AlishaG15/Lightbox-MedTechPrototyping/README.md

# Lightbox

A custom embedded systems project built for MedTech Prototyping (BME 254) at Duke University, Spring 2026 — a 3D-printed panda enclosure housing a hand-soldered PCB, Arduino Nano Every, and three independently controlled LEDs (two eyes and a nose).

---

## Overview

When a button is pressed, the panda's eyes light up for 5 seconds and its nose blinks for 10 seconds. The brightness of the eyes and blink rate of the nose are each controlled by a dedicated potentiometer mounted in the ears. An onboard heartbeat LED blinks at 1 Hz in all states to confirm the device is running.

---

## Hardware

| Component | Detail |
|---|---|
| Microcontroller | Arduino Nano Every (ATmega4809) |
| PCB | Custom single-sided board, hand-milled and soldered |
| LED drivers | IRFZ44 N-channel MOSFETs |
| Enclosure | 3D-printed PLA, two-part snap fit |
| Power | 9 V battery with SPST toggle switch |
| Controls | SPST push button + 2× 10 kΩ potentiometers |

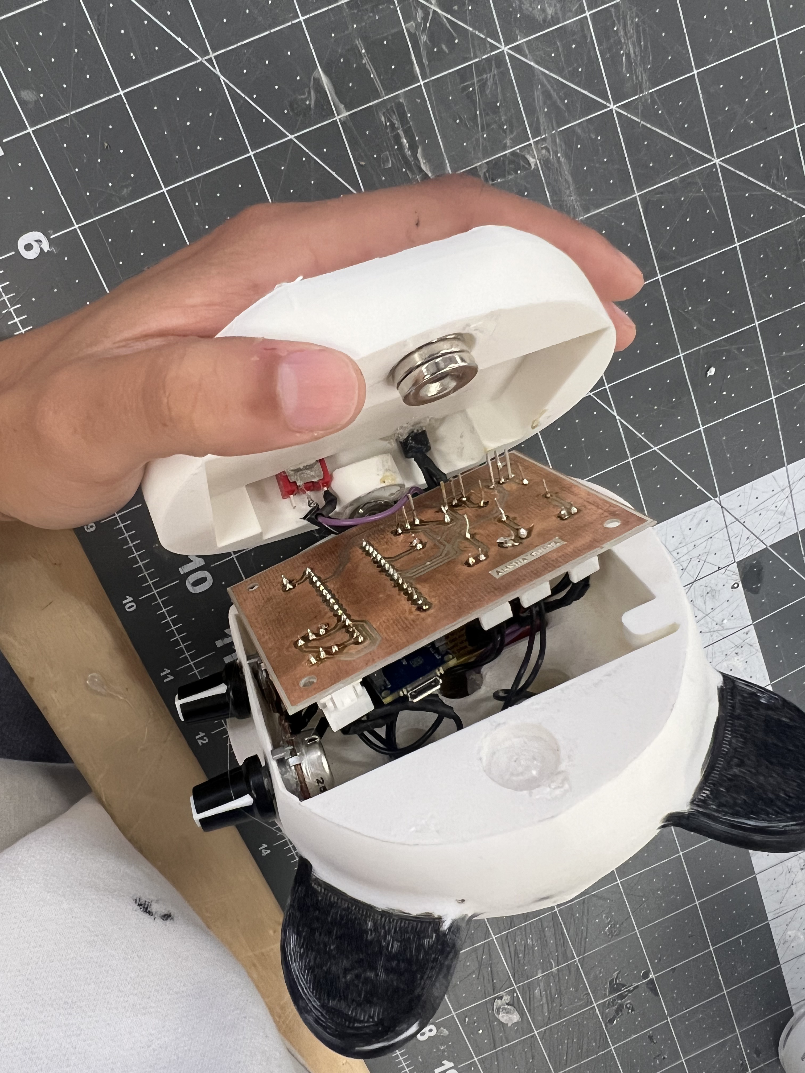
[picture p1: images/IMG_6919.jpeg]
Internals

Side view with potentiometers


---

## Firmware

Written in C++ using the Arduino framework via PlatformIO. Key design decisions:

- **State machine** with three explicit states: `IDLE`, `ANALOG_READ`, and `LED_OUTPUT`
- **Interrupt-driven** button input using `attachInterrupt()` — no polling in the main loop
- **Non-blocking timing** throughout using `millis()` — no `delay()` calls anywhere
- **PWM brightness control** on the eye LEDs via `analogWrite()`, mapped linearly from the potentiometer ADC reading
- **Clean digital blink** on the nose LED using `digitalWrite()` to avoid the Nano Every's 255/256 PWM artifact
- All pin assignments and timing constants defined as `#define` macros at the top of the file

```
IDLE ──(button press)──▶ ANALOG_READ ──▶ LED_OUTPUT ──(10 s elapsed)──▶ IDLE
```

---

## Testing Results

All measurements taken with a Tektronix TBS 1102B oscilloscope. Full analysis, with regression fits and 95% confidence intervals, is in the [technical report](testing/technical_report.ipynb) ([HTML version](testing/technical_report.html)); raw data is in [`testing/`](testing).

**Heartbeat LED**
- Period: 1000 ms, Frequency: 1.000 Hz, Duty cycle: 50.0%
- Identical in both IDLE and LED_OUTPUT states
- Zero measurable variation across 10 trials in each state (limited by oscilloscope resolution)

**Eye LED brightness (vs. potentiometer resistance)**
- Linear relationship (R² ≈ 1.0) from 0% duty cycle at max resistance to ~80% at minimum
- Did not reach 100% due to potentiometer mechanical travel limits

**Nose LED blink rate (vs. potentiometer resistance)**
- Linear relationship from 5.00 Hz (max resistance) to 7.45 Hz (min resistance)
- Lower bound matches spec exactly; upper bound limited by the same pot range constraint

---

## Gallery

| Assembled | Back panel |
|---|---|
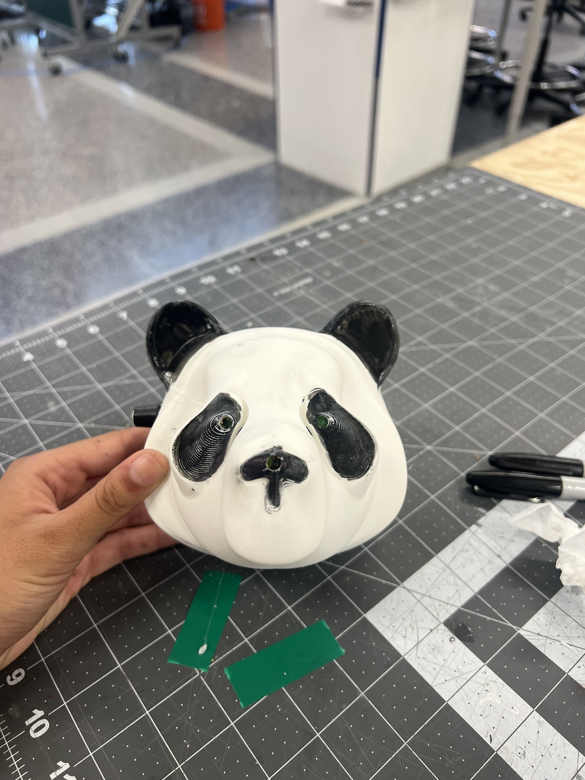
[picture p3: images/IMG_6915.jpeg]
front
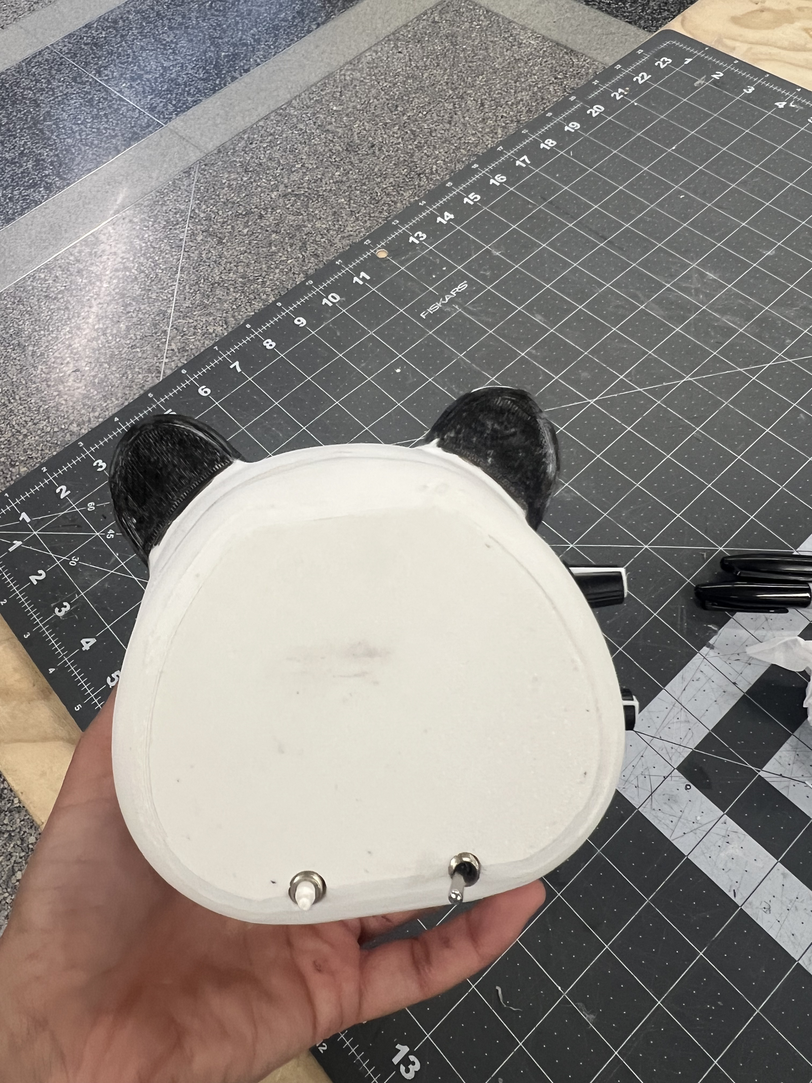
[picture p4: images/IMG_6917.jpeg]
back
|  |  |

| Internals (PCB) | Internals (Arduino + connectors) |
|---|---|
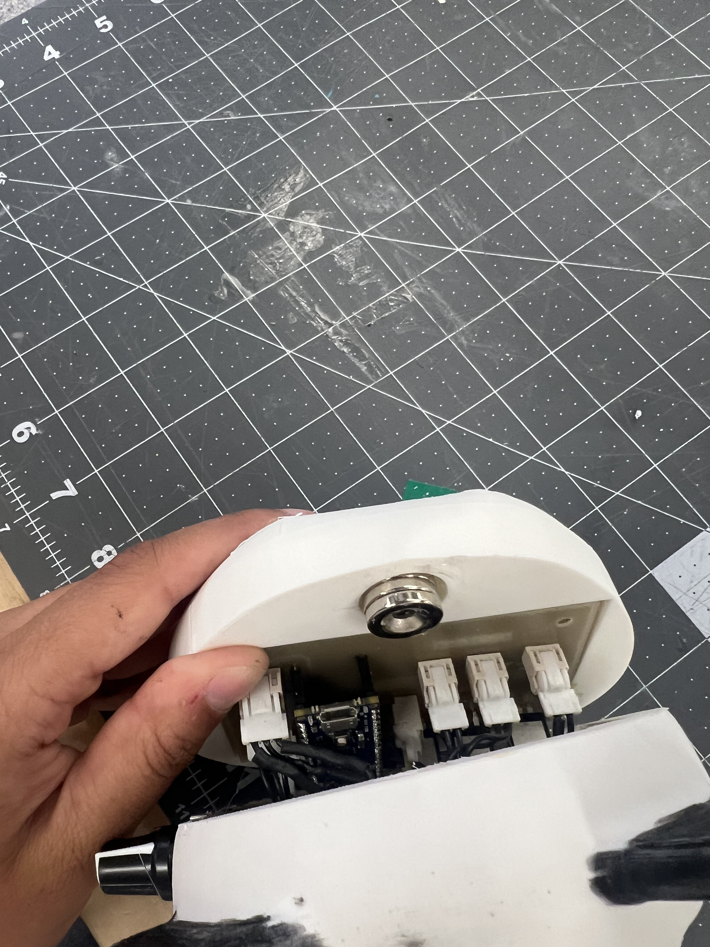
[picture p5: images/IMG_6920.jpeg]
arduino
| pcb |  |

---

## Repository Layout

| Folder | Contents |
|---|---|
| [`src/`](src) | Firmware (`main.cpp`) |
| [`circuit/`](circuit) | KiCad schematic, PCB layout and MOSFET footprint |
| [`cad/`](cad) | Enclosure renders |
| [`testing/`](testing) | Oscilloscope data and technical report |
| [`images/`](images) | Photos of the assembled device |

---

## Built With

- **PlatformIO** — build system and upload toolchain
- **KiCad** — schematic capture and PCB layout
- **Fusion 360 / CAD** — enclosure design
- **Python / Jupyter** — data analysis and technical report (scipy, matplotlib, pandas)
