AlishaG15/Lightbox-MedTechPrototyping/images/IMG_6918.jpeg

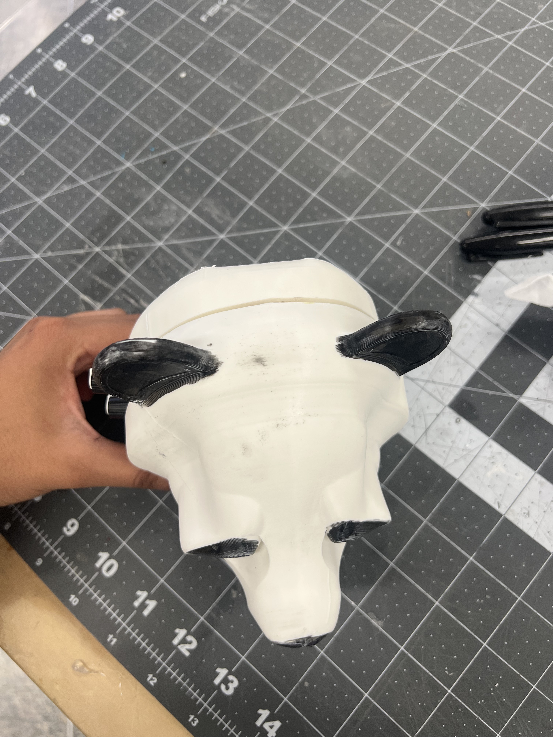
images/IMG_6918.jpeg
