AlishaG15/Lightbox-MedTechPrototyping/circuit/IRFZ44N/IRFZ44N.step

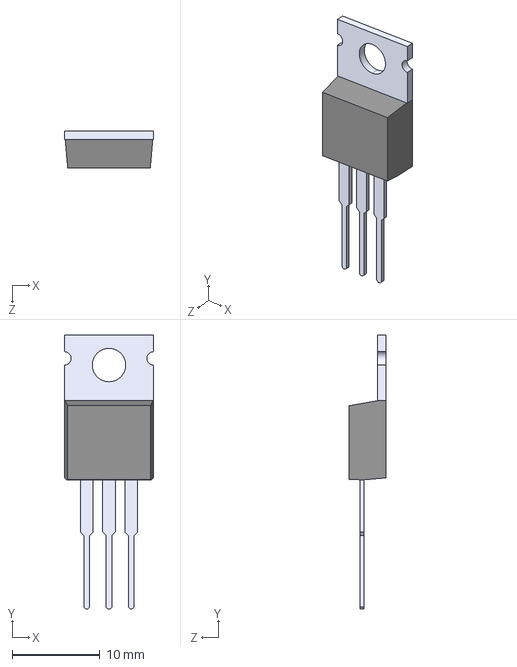
[picture p10: CAD file, 2025-03-25]
circuit/IRFZ44N/IRFZ44N.step
10.2 x 31.2 x 4.19 mm
