AlishaG15/Lightbox-MedTechPrototyping/testing/data_eye.csv

resistance_kohms | duty_cycle_pct
4.618 | 0.0
4.618 | 0.0
4.618 | 0.0
4.618 | 0.0
4.618 | 0.0
4.483 | 20.7
4.483 | 20.0
4.483 | 20.6
4.483 | 20.8
4.483 | 20.3
3.438 | 40.4
3.438 | 40.3
3.438 | 40.5
3.438 | 40.3
3.438 | 40.4
2.020 | 60.4
2.020 | 60.4
2.020 | 60.6
2.020 | 60.6
2.020 | 60.6
0.002 | 80.3
0.002 | 80.1
0.002 | 80.1
0.002 | 80.7
0.002 | 80.1
