AlishaG15/Lightbox-MedTechPrototyping/testing/data_heartbeat.csv

state | trial | period_ms | frequency_hz | duty_cycle_pct
IDLE | 1 | 1000 | 1.000 | 50.0
IDLE | 2 | 1000 | 1.000 | 50.0
IDLE | 3 | 1000 | 1.000 | 50.0
IDLE | 4 | 1000 | 1.000 | 50.0
IDLE | 5 | 1000 | 1.000 | 50.0
IDLE | 6 | 1000 | 1.000 | 50.0
IDLE | 7 | 1000 | 1.000 | 50.0
IDLE | 8 | 1000 | 1.000 | 50.0
IDLE | 9 | 1000 | 1.000 | 50.0
IDLE | 10 | 1000 | 1.000 | 50.0
LED_OUTPUT | 1 | 1000 | 1.000 | 50.0
LED_OUTPUT | 2 | 1000 | 1.000 | 50.0
LED_OUTPUT | 3 | 1000 | 1.000 | 50.0
LED_OUTPUT | 4 | 1000 | 1.000 | 50.0
LED_OUTPUT | 5 | 1000 | 1.000 | 50.0
LED_OUTPUT | 6 | 1000 | 1.000 | 50.0
LED_OUTPUT | 7 | 1000 | 1.000 | 50.0
LED_OUTPUT | 8 | 1000 | 1.000 | 50.0
LED_OUTPUT | 9 | 1000 | 1.000 | 50.0
LED_OUTPUT | 10 | 1000 | 1.000 | 50.0
