AlishaG15/Lightbox-MedTechPrototyping/testing/data.csv

Ideal Period (ms) | Measurement Period (ms)
1000 | 1005
1000 | 1003
1000 | 1001
1000 | 990
1000 | 995
500 | 490
500 | 495
500 | 497
500 | 492
500 | 491
2000 | 2100
2000 | 2000
2000 | 2300
2000 | 1900
2000 | 1950
