AlishaG15/Lightbox-MedTechPrototyping/testing/data_nose.csv

resistance_kohms | frequency_hz | period_ms
0.002 | 7.441 | 134.3
0.002 | 7.452 | 134.2
0.002 | 7.446 | 134.2
0.002 | 7.452 | 134.1
0.002 | 7.342 | 136.2
1.566 | 6.897 | 145.0
1.566 | 6.849 | 146.0
1.566 | 6.849 | 146.0
1.566 | 6.849 | 146.0
1.566 | 6.849 | 146.0
3.420 | 6.089 | 164.0
3.420 | 6.135 | 163.0
3.420 | 6.135 | 163.0
3.420 | 6.135 | 163.0
3.420 | 6.135 | 163.0
4.320 | 5.376 | 186.0
4.320 | 5.376 | 186.0
4.320 | 5.376 | 186.0
4.320 | 5.376 | 186.0
4.320 | 5.376 | 186.0
4.622 | 5.051 | 198.0
4.622 | 5.000 | 200.0
4.622 | 5.051 | 198.0
4.622 | 5.051 | 198.0
4.622 | 5.051 | 198.0
