AlishaG15/Lightbox-MedTechPrototyping/circuit/circuit.kicad_pcb

## KiCad design circuit/circuit.kicad_pcb (2026-04-01)

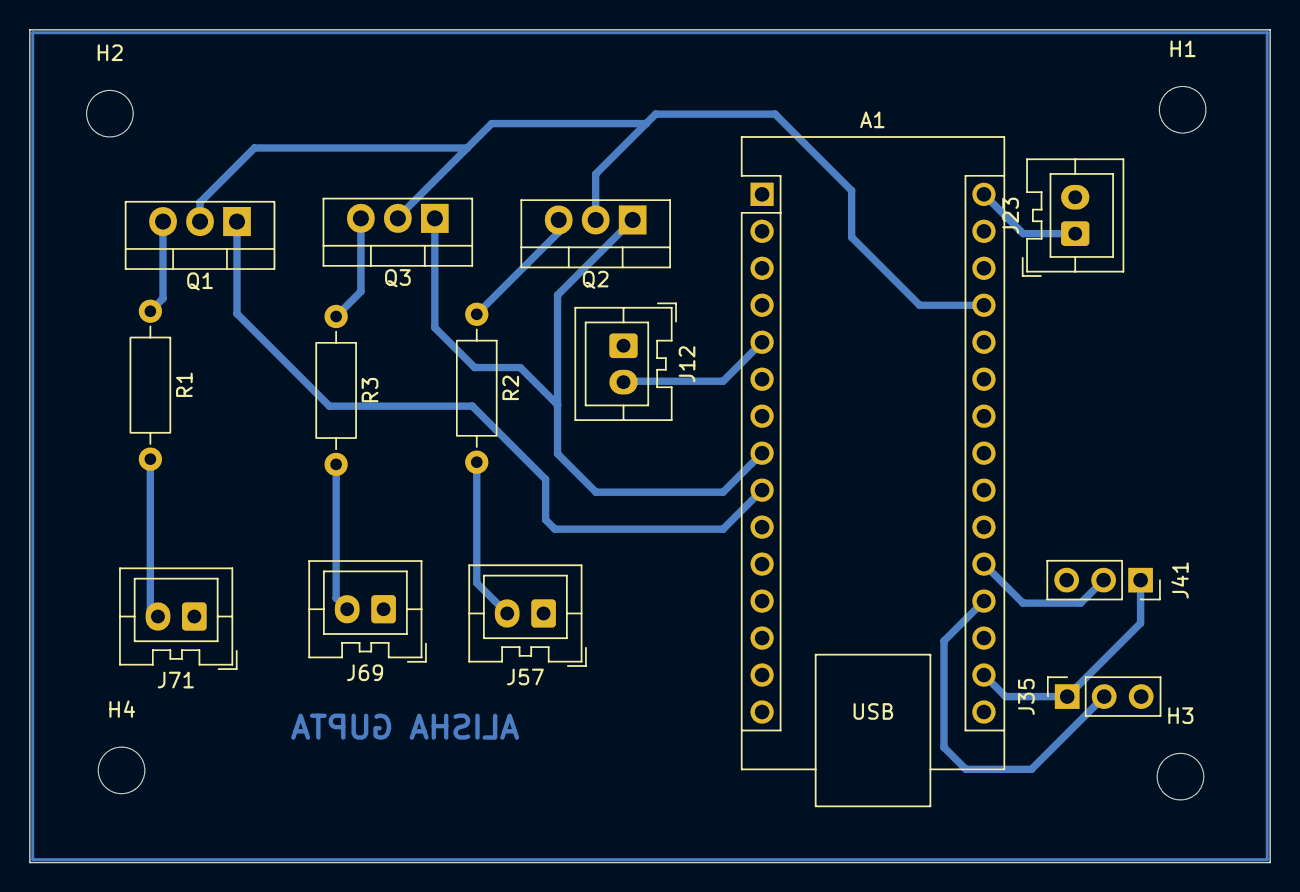
[picture p11: board circuit.kicad_pcb from above]

Board: 2 copper layers, 85.2 x 57.2 mm, 18 parts (0 on the bottom side), 15 nets.

Parts:
A1: Arduino_Nano_Every; Arduino_Nano
H1, H2, H3, H4: MountingHole; MountingHole_3.2mm_M3
J12, J23: Conn_01x02_Pin; JST_XA_B02B-XASK-1_1x02_P2.50mm_Vertical
J35: POT_BRIGHT_CONN; PinSocket_1x03_P2.54mm_Vertical
J41: POT_BLINK_CONN; PinSocket_1x03_P2.54mm_Vertical
J57, J69, J71: B02B-XASK-1; JST_XA_B02B-XASK-1_1x02_P2.50mm_Vertical
Q1, Q2, Q3: IRFZ44N; TO-220-3_Vertical
R1, R2, R3: 1k; R_Axial_DIN0207_L6.3mm_D2.5mm_P10.16mm_Horizontal

Connections:
+3.3V: A1.17 (3V3), J35.1, J41.1
+5V: A1.27 (+5V), Q1.2, Q2.2, Q3.2
+9V: A1.30 (VIN), J23.1
BLINK_OUT: A1.9 (D6), Q1.1
BRIGHT_OUT: A1.8 (D5), Q2.1, Q3.1
BUTTON_IN: A1.5 (D2), J12.2
GND: A1.4 (GND), A1.29 (GND), J12.1, J23.2, J35.3, J41.3, J57.1, J69.1, J71.1
unnamed: J57.2, R2.2
unnamed: J69.2, R3.2
unnamed: J71.2, R1.2
unnamed: Q1.3, R1.1
unnamed: Q2.3, R2.1
unnamed: Q3.3, R3.1
POT_BLINK: A1.20 (A1), J41.2
POT_BRIGHT: A1.19 (A0), J35.2
