AlishaG15/Lightbox-MedTechPrototyping/Lightbox V2/circuit copy/circuit.kicad_sch

## KiCad design Lightbox V2/circuit copy/circuit.kicad_sch (2026-03-29)

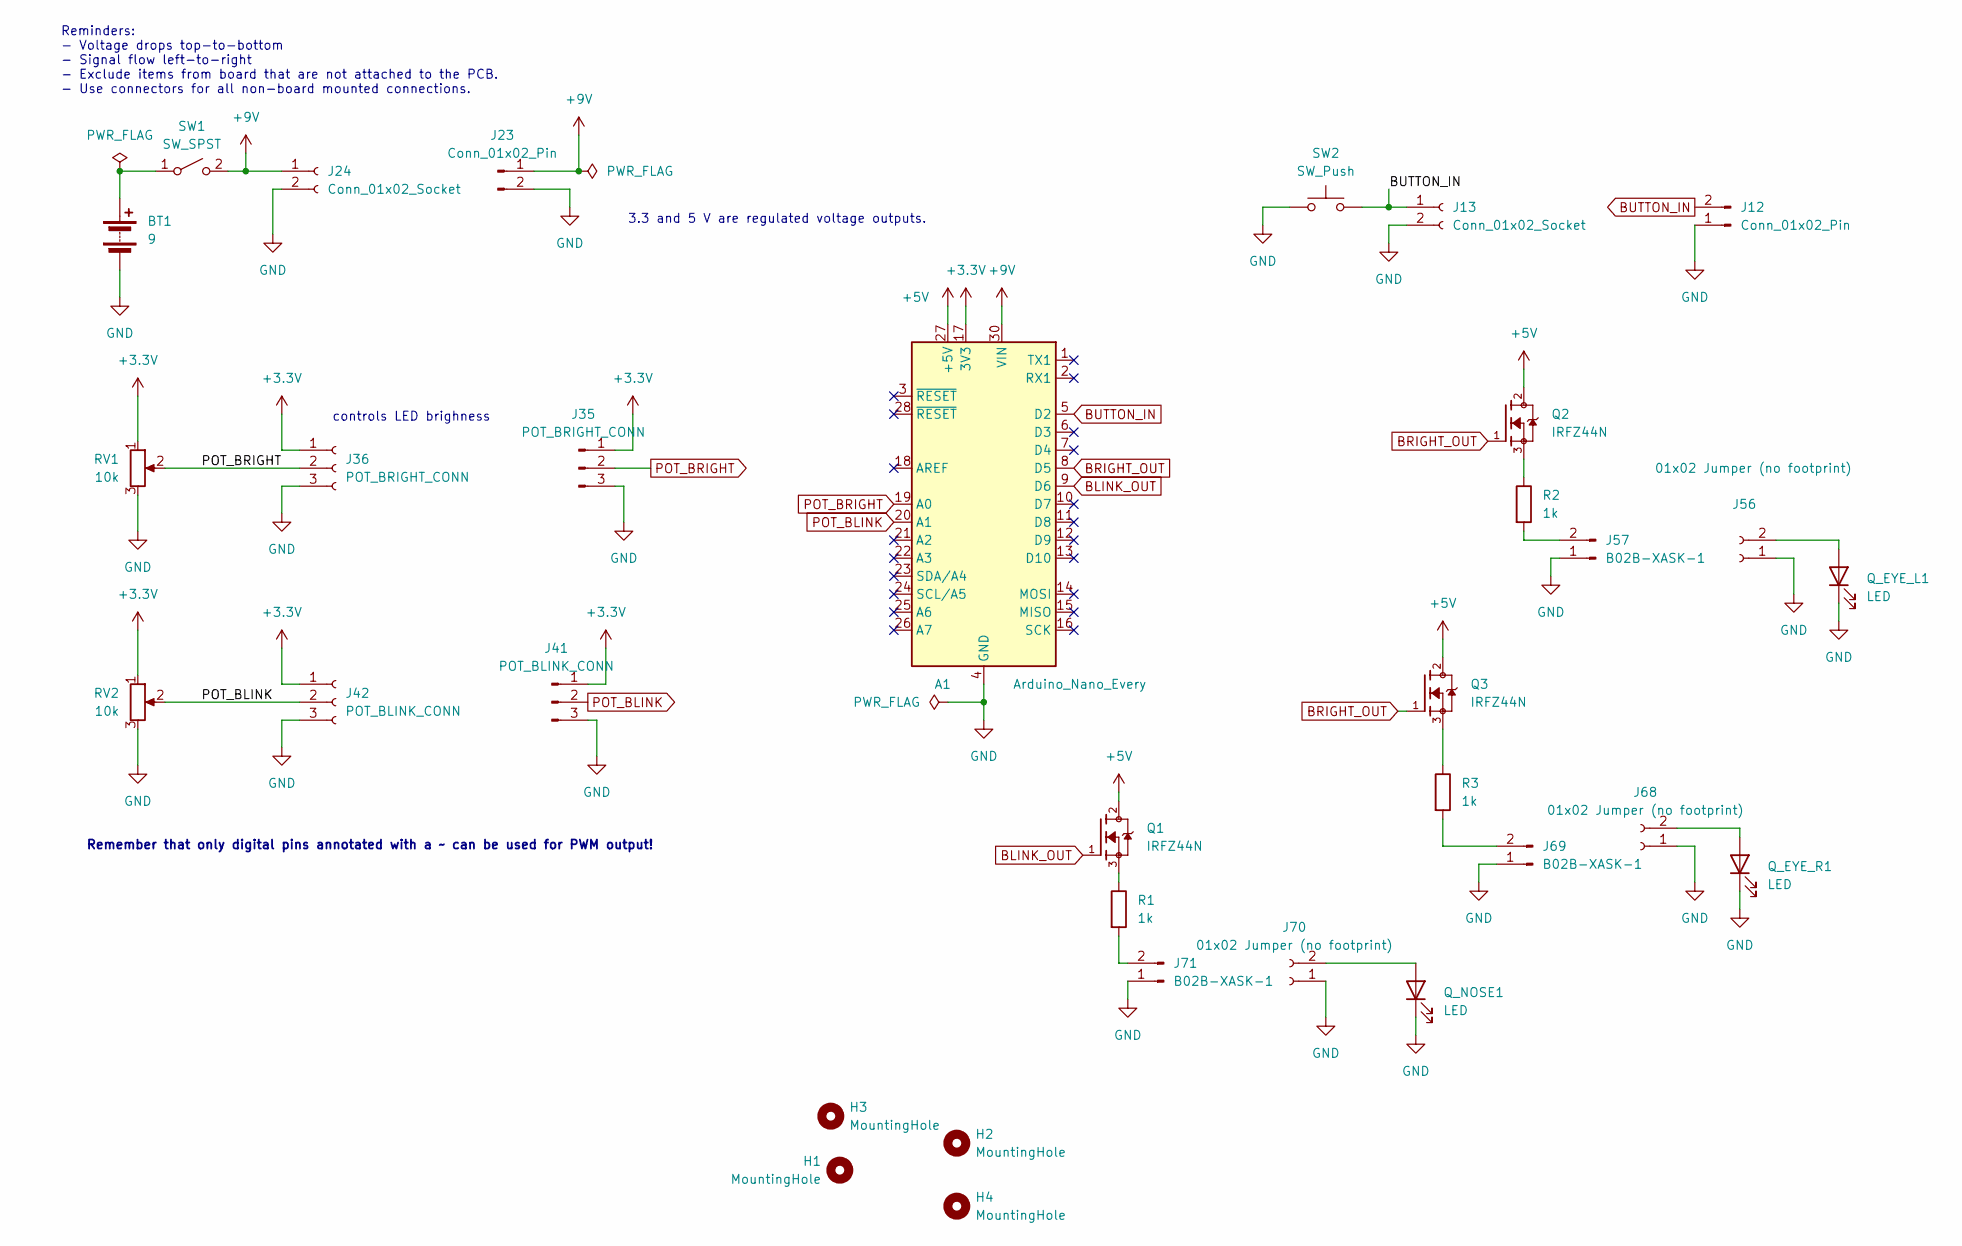
[picture p12: schematic circuit.kicad_sch]

Parts:
A1: Arduino_Nano_Every; Arduino_Nano
BT1: 9
H1, H2, H3, H4: MountingHole; MountingHole_3.2mm_M3
J12, J23: Conn_01x02_Pin; JST_XA_B02B-XASK-1_1x02_P2.50mm_Vertical
J13, J24: Conn_01x02_Socket; JST_XA_B02B-XASK-1_1x02_P2.50mm_Vertical
J35: POT_BRIGHT_CONN; PinSocket_1x03_P2.54mm_Vertical
J36: POT_BRIGHT_CONN
J41: POT_BLINK_CONN; PinSocket_1x03_P2.54mm_Vertical
J42: POT_BLINK_CONN
J56, J68, J70: 01x02 Jumper (no footprint)
J57, J69, J71: B02B-XASK-1; JST_XA_B02B-XASK-1_1x02_P2.50mm_Vertical
Q1, Q2, Q3: IRFZ44N; TO-220-3_Vertical; PARTREV 09/21/10
Q_EYE_L1: LED
Q_EYE_R1: LED
Q_NOSE1: LED
R1, R2, R3: 1k; R_Axial_DIN0207_L6.3mm_D2.5mm_P10.16mm_Horizontal
RV1, RV2: 10k
SW1: SW_SPST
SW2: SW_Push

Connections:
+3.3V: A1.17 (3V3), J35.1, J36.1, J41.1, J42.1, RV1.1, RV2.1
+5V: A1.27 (+5V), Q1.2, Q2.2, Q3.2
+9V: A1.30 (VIN), J23.1, J24.1, SW1.2 (B)
BLINK_OUT: A1.9 (D6), Q1.1
BRIGHT_OUT: A1.8 (D5), Q2.1, Q3.1
BUTTON_IN: A1.5 (D2), J12.2, J13.1, SW2.2
GND: A1.4 (GND), A1.29 (GND), BT1.2 (-), J12.1, J13.2, J23.2, J24.2, J35.3, J36.3, J41.3, J42.3, J56.1, J57.1, J68.1, J69.1, J70.1, J71.1, Q_EYE_L1.1 (K), Q_EYE_R1.1 (K), Q_NOSE1.1 (K), RV1.3, RV2.3, SW2.1
unnamed: BT1.1 (+), SW1.1 (A)
unnamed: J56.2, Q_EYE_L1.2 (A)
unnamed: J57.2, R2.2
unnamed: J68.2, Q_EYE_R1.2 (A)
unnamed: J69.2, R3.2
unnamed: J70.2, Q_NOSE1.2 (A)
unnamed: J71.2, R1.2
unnamed: Q1.3, R1.1
unnamed: Q2.3, R2.1
unnamed: Q3.3, R3.1
POT_BLINK: A1.20 (A1), J41.2, J42.2, RV2.2
POT_BRIGHT: A1.19 (A0), J35.2, J36.2, RV1.2

Notes on the sheet:
3.3 and 5 V are regulated voltage outputs.
controls LED brighness
Reminders: - Voltage drops top-to-bottom - Signal flow left-to-right - Exclude items from board that are not attached to the PCB. - Use connectors for all non-board mounted connections.
Remember that only digital pins annotated with a ~ can be used for PWM output!
