AlishaG15/Lightbox-MedTechPrototyping/(commit log)

2023-04-12 add button interrupt and blinking LED logic
2023-04-13 Add more functionality.
    * One-shot mode
    * Comments (including where timers should be used)
    * Sleep mode
2023-04-18 add analog voltage read hooks
2023-04-18 WIP: add KiCad ckt
    [circuit.kicad_pcb, circuit.kicad_sch]
2023-04-19 update schematic with components and notes
    [circuit.kicad_sch]
2023-04-19 ignore VS Code and KiCad local settings/backups
2023-04-19 update with schematic and firmware notes
2023-04-19 fix path to circuit schematic png
2023-04-20 Add digital writes for inv LED.
    * Add inv led writes opposite of non-inv led
    * Make sure off when device sleeps.
    * TECH DEBT - non-ideal sequential timing.
2023-04-20 fix logic from Hz -> ms
    [main.cpp]
2023-04-21 Fix and complete code to work with both microcontrollers.
    * Comment out AVR-specific sleep library and associated code.
    * Add all monostable calculations.
    * Add INF and DBG logs.
    * Only read analog voltages at the start of the button press ON
    interval.
    [main.cpp]
2023-04-26 FIX D8 -> D10; analog read float typecast
    [main.cpp]
2023-04-27 refactor serial print statements
2023-04-27 UNTESTED: using millis timer and hook for variable duty cycle
2023-04-28 Implemented logic for millis-timer blink rate and duty cycle.
    TODO: Test with o-scope
2023-04-28 Fix timinig logic.
    * Remove serial print statements that were taking too long relative to
    the blink rate.
    * Avoid initial blink bias by not starting the timing based on the
    button press, but after the analog reads.
    * Correct next on/off time calculation logic.
    [main.cpp]
2023-10-09 add pinout and PlatformIO config for Arduino Nano
2023-10-09 add heartbeat LED spec
2023-10-20 add note about emulating button by connection to GND
2024-03-18 limit board configs to Arduino Nano Every
2024-03-18 update project for S24, including testing section and explicit state machine framework
2024-03-18 add threaded inserts resource
2024-03-26 add PWM hyperlinks
2024-03-30 add resistor footprint example
2024-03-30 adjust size of the resistor footprint image
2024-10-15 add technical report template
    [data.csv]
2024-10-15 add example enclosures
2024-11-04 update tech report example to include linear fit w/ 95% CI
    [data.csv, linear_regression_data.csv]
2024-11-08 ignore KiCad *.lck files
2025-03-25 Add IRFZ44 KiCad symbol and footprint.
    `sym-lib-table` allows the part to be seen in the project-specific library
    Closes #6
    [IRFZ44N.step]
2025-03-25 Update KiCad template project.
    * Remove confusing pseudo-connections and test points.
    * Add heirarchecal sheets for different sub-circuits.
    * Add placeholder metadata in the schematic.
    * Add pinout for the Arduino Nano Every.
    Closes #5
    [button_n_pots.kicad_sch, circuit.kicad_sch, eyes_n_nose.kicad_sch, power.kicad_sch]
2025-03-25 Update handout for S25.
    * Remove confusing mock circuit schematic.
    * Update code boilerplate to match handout better.
    * Get rid of unused `go_to_sleep()` function and the associated library include.
    * Add extra note about valid PWM pins.
    * Update what the submit (Gitlab and Gradescope components)
    * Remove requirement to present device.
2025-03-25 Add requirement to drive each LED with IRFZ44 MOSFET.
    Issue #6
2025-03-25 Updates to handout for S25.
    * Move images to an images/ dir.
    * Add connector interference image.
    * Convert to using HTML image rendering to control image width.
    * Ignore KiCad cache file and DS_Store
    * Add starter parts in KiCad schematic.
    * Update URL hyperlink formatting.
    [button_n_pots.kicad_sch, circuit.kicad_sch, eyes_n_nose.kicad_sch, power.kicad_sch]
2025-03-25 add example connectors to use in schematic
    [circuit.kicad_sch, power.kicad_sch]
2025-03-27 update analysis ask for heartbeat LED
2025-04-07 Update footprints and values.
    * Convert the `IRFZ44N` to use a generic TO-220 vertical footprint since
    the custom footprint isn't importing correctly.
    * Update the footprints for the socket connectors and the resistors.
    * Exclude some components from the board.
    * Add some nominal part values (e.g., battery).
    [button_n_pots.kicad_sch, circuit.kicad_pcb, circuit.kicad_sch, eyes_n_nose.kicad_sch, power.kicad_sch]
2026-02-04 consolidate schematic to single root page
    [button_n_pots.kicad_sch, circuit.kicad_sch, eyes_n_nose.kicad_sch, power.kicad_sch]
2026-02-04 Add clearance around PinHeader footprint.
    The default footprint for the 1x2 pin header was too small, leading to
    connectors physically conflicting with one another on the PCB.
    This adds 125 mil of clearance to the DRU for this footprint, based on
    the B02B-XASK-1 2-pin connector that we are using.
2026-02-04 add more clearance around holes
2026-02-04 update footprint for pin socket to B02B-XASK-1
    [circuit.kicad_sch]
2026-02-04 Remove unnecessary clearance rule around 1x2 connector.
    1. This didn't work as intended.
    2. The actual B02B-XASK-1 connector footprint is available to use!
2026-02-04 rm pic of connector interference now that correct footprint is being used
2026-02-04 rm resistor footprint image (proper footpring used in KiCad)
2026-02-04 add more notes about excluding things from board and connectors
    [circuit.kicad_sch]
2026-02-04 change order of section for more logical flow
2026-02-24 connected battery to switch via pins
    [circuit.kicad_sch]
2026-02-24 added all components via pins or on-board
    [circuit.kicad_sch]
2026-02-26 add 3-pin connector and jumper
2026-03-05 updated footprints, pcb components, mounting holes, and edge cuts
    [circuit.kicad_pcb, circuit.kicad_sch]
2026-03-16 made changes to lightbox pcb - fix mistakes from KiCad Review Issue
    [circuit.kicad_pcb, circuit.kicad_sch]
2026-03-16 deleted red filled zone
    [circuit.kicad_pcb]
2026-03-18 Fixed B. Cu layer and moved parts to correct layer (revision number v1.1.1)
    [circuit.kicad_pcb, circuit.kicad_sch]
2026-03-18 updated name to GND
    [circuit.kicad_pcb]
2026-03-18 moved mounting holes
    [circuit.kicad_pcb]
2026-03-29 Revert "moved mounting holes"
    This reverts commit 6c6eda3e60cd54308894f1d0f9ce76ea73f12124.
    [circuit.kicad_pcb]
2026-03-29 added second version of pcb smaller and more compact
    [IRFZ44N.step, circuit.kicad_pcb, circuit.kicad_sch, data.csv, linear_regression_data.csv]
2026-03-29 updated folder directory and added v2 of pcb
    [IRFZ44N.step, circuit.kicad_pcb, circuit.kicad_sch, data.csv, linear_regression_data.csv]
2026-04-01 uploaded pcb with metadata
    [circuit.kicad_pcb, circuit.kicad_sch]
2026-04-01 Revert "uploaded pcb with metadata"
    This reverts commit 118884daa18b4dd73780fb005e8cf3b07a4ea623.
    [circuit.kicad_pcb, circuit.kicad_sch]
2026-04-01 pushing v2 out again deleted lightboxV1 and lightboxV2 folders
    [circuit.kicad_pcb]
2026-04-11 updated firmware for review
    [data_eye.csv, data_heartbeat.csv, data_nose.csv]
2026-04-27 finished testing, technical report, and images
    [data_eye.csv, data_heartbeat.csv, data_nose.csv]
