AlishaG15/Lightbox-MedTechPrototyping/images/IMG_6916.jpeg

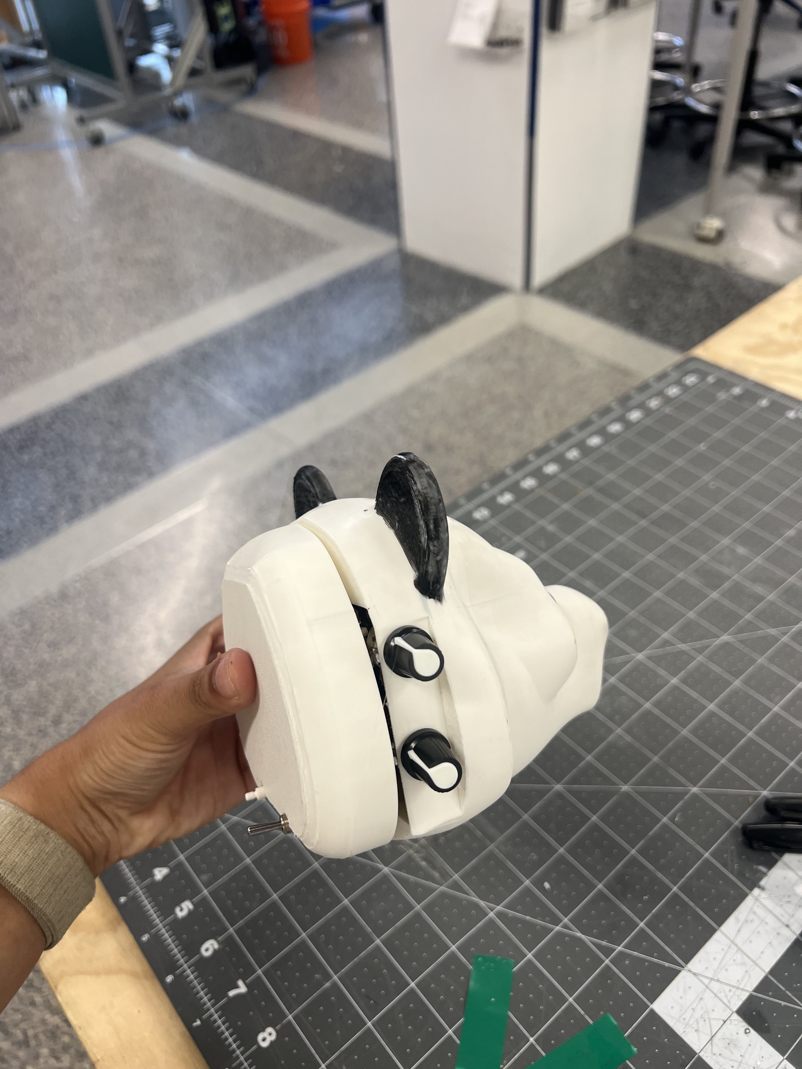
[picture p2: images/IMG_6916.jpeg]
images/IMG_6916.jpeg
